Blinkinlabs/AnalogLedFader/readme.markdown

Analog LED Fader

An Arduino-compatible, DMX-like analog LED controller

Our VID/PID: 0x1d50/0x605e
