Blinkinlabs/AnalogLedFader/(commit log)

2013-01-07 DMX Analog LED is a control board for 8 or 16 channels of analog LED chains.
    Each output is spec'd to 3A at 12V.
    [DmxAnalogLed.brd, DmxAnalogLed.sch]
2013-01-08 Add isolated RS485 circuit, begin transistor layout
    [DmxAnalogLed.brd, DmxAnalogLed.sch]
2013-01-10 Board update
    [DmxAnalogLed.brd]
2013-02-01 Remove PWM chip, start routing board
    [DmxAnalogLed.brd, DmxAnalogLed.sch]
2013-02-01 Start laying out board
    [DmxAnalogLed.brd, DmxAnalogLed.sch]
2013-02-02 Routed, pending review
    [DmxAnalogLed.brd, DmxAnalogLed.sch]
2013-02-06 Add pwm test firmware
2013-02-06 Software PWM @325Hz. Has stability issues on the low end
    [firmware.ino]
2013-02-07 Last ditch: unroll stepping loop for short duration PWM. It's still a bit too unstable.
2013-02-14 Re-wire PWMs for hardware PWM generation. Bugfix: Serial should be connected to AVR RX, not TX
    [DmxAnalogLed.brd, DmxAnalogLed.sch]
2013-02-14 Almost ready for a re-release of RevA
    [DmxAnalogLed.brd, DmxAnalogLed.sch]
2013-02-16 Switch to hardware PWM. Limited to 6 channels, but can run at 16KHz.
2013-03-01 Re-order Hardware PWM library to match the PCB
2013-03-01 Add extra drain vias, space for mounting holes, line up connectors, drop series gate resistors, fix RX line
    [DmxAnalogLed.brd, DmxAnalogLed.sch]
2013-03-06 Release RevB
    [DmxAnalogLed.brd, DmxAnalogLed.sch]
2013-03-08 Notes from the RevA boards
2013-03-13 Fix LED port
2013-03-13 Update component values on PCB
    [DmxAnalogLed.brd, DmxAnalogLed.sch]
2013-03-16 Get RevB ready
    [DmxAnalogLed.brd, DmxAnalogLed.sch]
2013-03-16 RevB candidate; fixes ground plane, isolation, regulator placement, silk.
    [DmxAnalogLed.brd, DmxAnalogLed.sch]
2013-03-29 Firmware: reset all outputs to 0 on start. SerialDebugger: Output enough channels for a single board.
    [HardPWM.cpp, SerialDebugger.pde]
2013-03-29 Make the software faster.
    [DmxAnalogLed.brd, DmxAnalogLed.sch]
2013-06-09 Update examples to work with 13 boards, fix bugs that caused the serial formatting to be incorrect, fix the firmware!
    [DiscoParty.pde, HardPWM.cpp, HardPWM.h, LedOutput.pde, SerialDebugger.pde, firmware.ino]
2013-10-07 Name change
    [DmxAnalogLed.brd]
2013-10-07 Change library name, too
    [DmxAnalogLed.brd, DmxAnalogLed.sch]
2013-10-07 Rename board, too!
    [AnalogLedFader.brd, AnalogLedFader.sch]
